MechatronikMonkey/NixiePowerMeter/electronics/pcb/README.md

DXF‑Hilfsdateien (Board‑Outline, Keepouts, Panel‑Bohrungen) können hier abgelegt und in den PCB‑Editor importiert werden.
