MechatronikMonkey/NixiePowerMeter/electronics/pcb/NixiePM.step

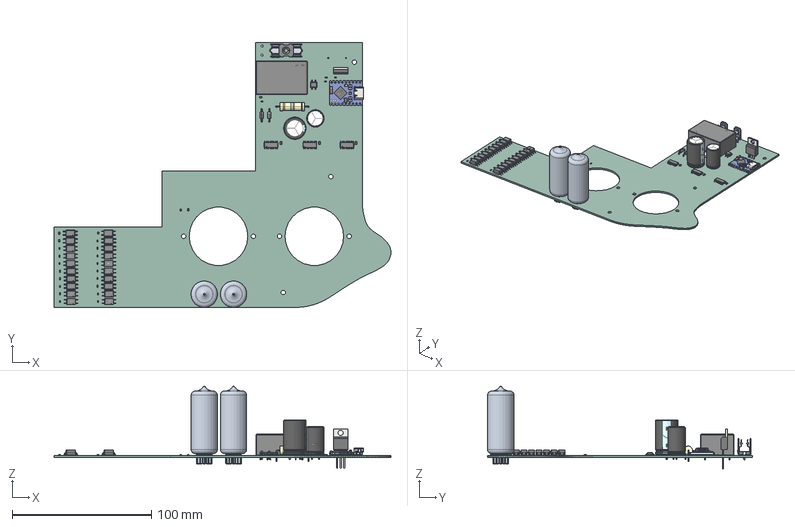
[picture p1: CAD file, 2026-01-16]
electronics/pcb/NixiePM.step
241.7 x 190.0 x 59.2 mm
C0805 x 4
R0603 x 24
C0603 x 2
DO-41_BD2.4-L4.7-P8.70-D0.8-RD x 2
SMD-4_L4.6-W6.4-P2.54-LS10.0-BR x 20
CAP-TH_BD16.0-P7.50-D1.2-FD
RES-TH_BD6.0-L17.5-P21.50-D0.8
SOIC-16_L9.9-W3.9-P1.27-LS6.0-BL x 3
FUSE-TH_L22.5-W10.8-P22.50_0031.8201.G
NixiePM 1.30.1 x 2
NixiePM 1.30.2 x 2
PWRM-TH_IRM-03-5-DIP5
ESP32-S3_Zero
CAP-TH_BD12.5-P5.00-D0.6-FD
TO-220-3_Vertical
MBS_L4.7-W4.0-P2.50-LS7.0-BL
NixiePM_PCB
