MechatronikMonkey/NixiePowerMeter/electronics/NixiePM.kicad_pcb

## KiCad design electronics/NixiePM.kicad_pcb (2026-01-21)

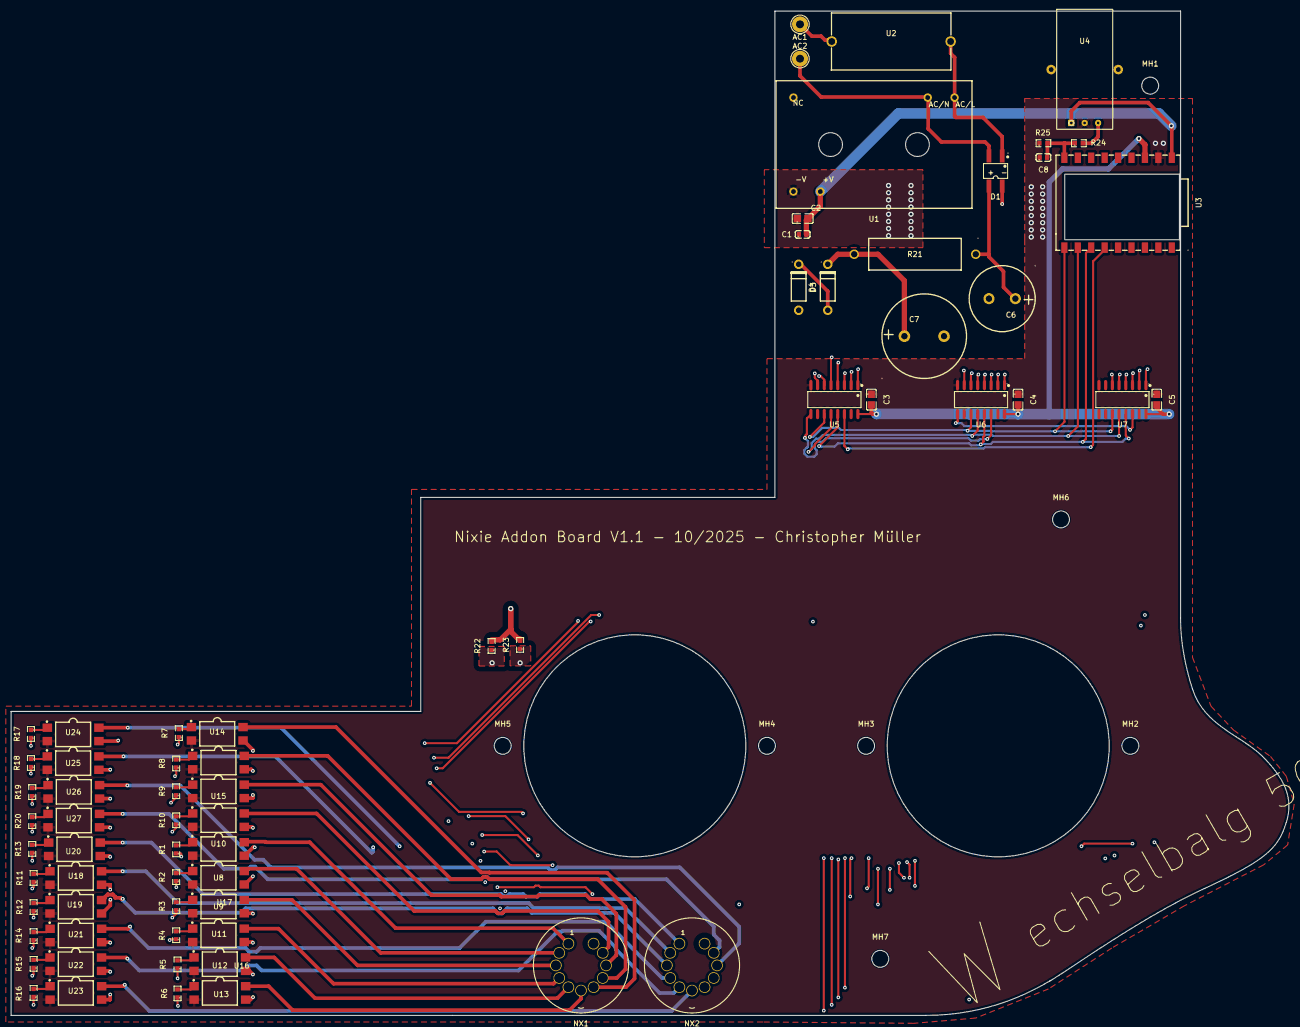
[picture p2: board NixiePM.kicad_pcb from above]

Board: 4 copper layers, 241.7 x 190.0 mm, 74 parts (0 on the bottom side), 80 nets.

Parts:
AC1, AC2: AC ~ 230V; TestPoint_THTPad_D3.0mm_Drill1.5mm
C1: CL10A475KO8NNNC; C0603
C2, C3, C4, C5: 100nF 50V X7R; C0805
C6: 33uF 500V 5R5-ESR; CAP-TH_BD12.5-P5.00-D0.6-FD
C7: 450BXW47MEFR16X25; CAP-TH_BD16.0-P7.50-D1.2-FD
C8: 0603B472K500NT; C0603
D1: MB26S_C475740; MBS_L4.7-W4.0-P2.50-LS7.0-BL
D3, D4: 2EZ91D5; DO-41_BD2.4-L4.7-P8.70-D0.8-RD
MH1, MH2, MH3, MH4, MH5, MH6, MH7: MountHole; MountingHole_3.2mm_M3
NX1, NX2: IN-8; IN-8_NIXIE
R1, R2, R3, R4, R5, R6, R7, R8, R9, R10, R11, R12, R13, R14, R15, R16, R17, R18, R19, R20: 0603WAF2000T5E; R0603
R21: CFR03SJ0153AA0_15k; RES-TH_BD6.0-L17.5-P21.50-D0.8
R22, R23: 0603WAF1002T5E; R0603
R24: 0603WAF1201T5E; R0603
R25: 0603WAF3301T5E; R0603
U1: IRM-03-5; PWRM-TH_IRM-03-5-DIP5
U2: 16A 20mm 500V 5mm Plugin Fuse; FUSE-TH_L22.5-W10.8-P22.50_0031.8201.G
U3: ESP32-ZERO; COMM-SMD_ESP32-ZERO
U4: QNHC3; HALL-SENSOR_5P-P2.54-H13.5
U5, U6, U7: 74HC595D,118; SOIC-16_L9.9-W3.9-P1.27-LS6.0-BL
U8, U9, U10, U11, U12, U13, U14, U15, U16, U17, U18, U19, U20, U21, U22, U23, U24, U25, U26, U27: KAQY214ATLD; SMD-4_L4.6-W6.4-P2.54-LS10.0-BR

Connections:
+3V3: C3.2, C4.2, C5.2, U3.21 (3V3), U5.16 (VCC), U6.16 (VCC), U7.16 (VCC)
+5V: C1.2, C2.2, U1.16 (+VO), U3.23 (5V), U4.1 (5V)
+182V: C7.1, D3.1 (K), R21.2, R22.2, R23.2
+325V: C6.1, D1.3 (+), R21.1
/Anode1: NX1.11 (A), R22.1
/Anode2: NX2.11 (A), R23.1
/Clock: U3.9 (GP7), U5.11 (SHCP), U6.11 (SHCP), U7.11 (SHCP)
/Data: U3.6 (GP10), U5.14 (DS)
/Enable: U3.7 (GP9), U5.13 (OE#), U6.13 (OE#), U7.13 (OE#)
/Latch: U3.8 (GP8), U5.12 (STCP), U6.12 (STCP), U7.12 (STCP)
/NixieDigit1/Digital: R1.1, U5.1 (Q1)
/NixieDigit1/Nixie: NX1.1 (K1), U10.4 (S)
/NixieDigit2/Digital: R2.1, U5.2 (Q2)
/NixieDigit2/Nixie: NX1.2 (K2), U8.4 (S)
/NixieDigit3/Digital: R3.1, U5.3 (Q3)
/NixieDigit3/Nixie: NX1.3 (K3), U9.4 (S)
/NixieDigit4/Digital: R4.1, U5.4 (Q4)
/NixieDigit4/Nixie: NX1.4 (K4), U11.4 (S)
/NixieDigit5/Digital: R5.1, U5.5 (Q5)
/NixieDigit5/Nixie: NX1.5 (K5), U12.4 (S)
/NixieDigit6/Digital: R6.1, U5.6 (Q6)
/NixieDigit6/Nixie: NX1.6 (K6), U13.4 (S)
/NixieDigit7/Digital: R7.1, U5.7 (Q7)
/NixieDigit7/Nixie: NX1.7 (K7), U14.4 (S)
/NixieDigit8/Digital: R8.1, U6.1 (Q1)
/NixieDigit8/Nixie: NX1.8 (K8), U15.4 (S)
/NixieDigit9/Digital: R9.1, U6.2 (Q2)
/NixieDigit9/Nixie: NX1.9 (K9), U16.4 (S)
/NixieDigit10/Digital: R10.1, U6.3 (Q3)
/NixieDigit10/Nixie: NX1.10 (K0), U17.4 (S)
/NixieDigit11/Digital: R13.1, U6.4 (Q4)
/NixieDigit11/Nixie: NX2.1 (K1), U20.4 (S)
/NixieDigit12/Digital: R11.1, U6.5 (Q5)
/NixieDigit12/Nixie: NX2.2 (K2), U18.4 (S)
/NixieDigit13/Digital: R12.1, U6.6 (Q6)
/NixieDigit13/Nixie: NX2.3 (K3), U19.4 (S)
/NixieDigit14/Digital: R14.1, U6.7 (Q7)
/NixieDigit14/Nixie: NX2.4 (K4), U21.4 (S)
/NixieDigit15/Digital: R15.1, U7.1 (Q1)
/NixieDigit15/Nixie: NX2.5 (K5), U22.4 (S)
/NixieDigit16/Digital: R16.1, U7.2 (Q2)
/NixieDigit16/Nixie: NX2.6 (K6), U23.4 (S)
/NixieDigit17/Digital: R17.1, U7.3 (Q3)
/NixieDigit17/Nixie: NX2.7 (K7), U24.4 (S)
/NixieDigit18/Digital: R18.1, U7.4 (Q4)
/NixieDigit18/Nixie: NX2.8 (K8), U25.4 (S)
/NixieDigit19/Digital: R19.1, U7.5 (Q5)
/NixieDigit19/Nixie: NX2.9 (K9), U26.4 (S)
/NixieDigit20/Digital: R20.1, U7.6 (Q6)
/NixieDigit20/Nixie: NX2.10 (K0), U27.4 (S)
AC1: D1.1 (AC), U1.1 (AC/L), U2.2
AC2: AC2.1, D1.2 (AC), U1.3 (AC/N)
GND: C1.1, C2.1, C3.1, C4.1, C5.1, C8.1, R25.1, U1.14 (-VO), U3.22 (GND), U4.2 (GND), U5.8 (GND), U6.8 (GND), U7.8 (GND), U8.2 (K), U9.2 (K), U10.2 (K), U11.2 (K), U12.2 (K), U13.2 (K), U14.2 (K), U15.2 (K), U16.2 (K), U17.2 (K), U18.2 (K), U19.2 (K), U20.2 (K), U21.2 (K), U22.2 (K), U23.2 (K), U24.2 (K), U25.2 (K), U26.2 (K), U27.2 (K)
GND-HV: C6.2, C7.2, D1.4 (-), D4.2 (A), U8.3 (S1), U9.3 (S1), U10.3 (S1), U11.3 (S1), U12.3 (S1), U13.3 (S1), U14.3 (S1), U15.3 (S1), U16.3 (S1), U17.3 (S1), U18.3 (S1), U19.3 (S1), U20.3 (S1), U21.3 (S1), U22.3 (S1), U23.3 (S1), U24.3 (S1), U25.3 (S1), U26.3 (S1), U27.3 (S1)
unnamed: AC1.1, U2.1
unnamed: D3.2 (A), D4.1 (K)
unnamed: C8.2, R24.1, R25.2, U3.15 (GP6)
unnamed: R24.2, U4.3 (OUT)
unnamed: U5.9 (Q7S), U6.14 (DS)
unnamed: U6.9 (Q7S), U7.14 (DS)
unnamed: R2.2, U8.1 (A)
unnamed: R3.2, U9.1 (A)
unnamed: R1.2, U10.1 (A)
unnamed: R4.2, U11.1 (A)
unnamed: R5.2, U12.1 (A)
unnamed: R6.2, U13.1 (A)
unnamed: R7.2, U14.1 (A)
unnamed: R8.2, U15.1 (A)
unnamed: R9.2, U16.1 (A)
unnamed: R10.2, U17.1 (A)
unnamed: R11.2, U18.1 (A)
unnamed: R12.2, U19.1 (A)
unnamed: R13.2, U20.1 (A)
unnamed: R14.2, U21.1 (A)
unnamed: R15.2, U22.1 (A)
unnamed: R16.2, U23.1 (A)
unnamed: R17.2, U24.1 (A)
unnamed: R18.2, U25.1 (A)
unnamed: R19.2, U26.1 (A)
unnamed: R20.2, U27.1 (A)
