MechatronikMonkey/NixiePowerMeter/electronics/fabrication/README.md

Ablage für Fertigungsdaten:
- gerbers/ Gerber‑Lagen
- drills/ Bohrdaten (Excellon)
- fab_notes/ Hinweise für Leiterplattenhersteller
- assembly/ Stückliste (BOM) und Pick&Place
