MechatronikMonkey/NixiePowerMeter/(commit log)

2025-10-13 first schematic drawing
    [NixiePM.kicad_pcb, NixiePM.kicad_sch, auxPower.kicad_sch, bom.csv, connectors.kicad_sch, controlls.kicad_sch, controls.kicad_sch, designators.csv]
2025-10-13 schematic ready, layout started
    [NixiePM.kicad_pcb, NixiePM.kicad_sch, nixieDigit.kicad_sch]
2025-11-12 update resistor
    [nixieDigit.kicad_sch]
2025-11-12 update resistor, update voltages
    [NixiePM.kicad_pcb, NixiePM.kicad_sch, bom.csv, designators.csv, nixieDigit.kicad_sch, positions.csv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]
2026-01-16 update schmatic
    [NixiePM.kicad_pcb, NixiePM.kicad_sch]
2026-01-16 update documentation
    [NixiePM.step, bom.csv, designators.csv, positions.csv]
2026-01-21 fix: schematic mistakes corrected
    [NixiePM.kicad_pcb, NixiePM.kicad_sch]
2026-01-21 fix: update software to use MR and correct bitshifting
    [main.c]
2026-01-21 fix: select correct ADC channel
    [main.c]
2026-01-21 fix: update pcb polygones
    [NixiePM.kicad_pcb]
2026-01-22 fix: watt calculation wrong
    [main.c]
2026-01-22 feature: zero point calibration
2026-01-26 fix: platform version problems with tasmota version. cannot be changed at the moment. needs investigation
    [main.c, ws2812_control.c]
